popovb/zxRebornClock/README.md

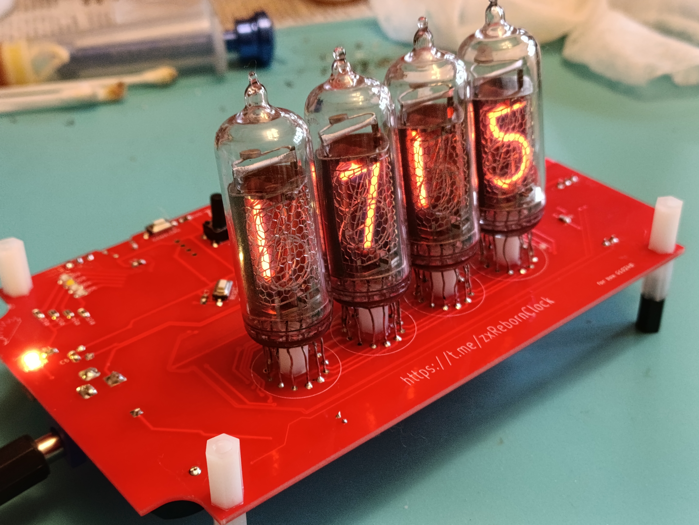
[picture p1: pics/03.jpg]

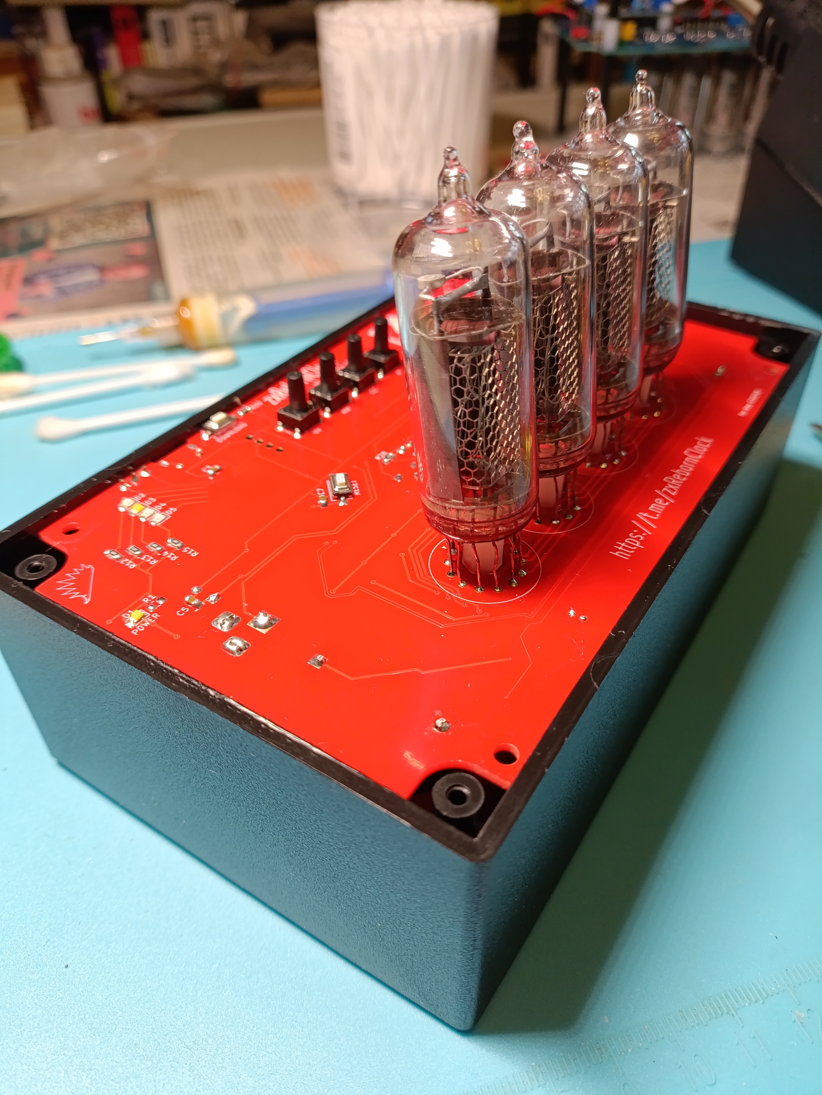
[picture p2: pics/04.jpg]


# ИНСТРУКЦИЯ ПО СБОРКЕ И ЗАПУСКУ

## Повышайка на 200 В

Запаиваем следующие элементы: `J1, U3, C8, R55, C9, L1, D8, C11, D7, Q12, R56, Q11, C10, R57, R58`.
Подключаем 12 В. На С11 долно быть около 200 В. Если есть, переходим к следующему шагу.

## Понижайка на 3.3 В

Запаиваем следующие элементы: `D6, C2, U2, C4, C5, R1, D1`. Подключаем 12 В. На C4 должно быть
3.3 В и горит D1. Если есть, переходим к следующему шагу.

## Микроконтроллер

Запаиваем: `U1, C1, J2, U4, R12-R15, D2-D5, Sw2-Sw6, R29-R33, R53, R54, J4`.

Идём сюда https://github.com/ch32-rs/wchisp/releases/tag/v0.3.0 и берём прошиватор
под нужную платформу. Как минимум работает в Debian и Windows 10.

Плата обесточена. Зажимаем кнопку Download, подрубаем usb кабель к компу, отпускаем кнопку и
у нас несколько секунд, чтобы запустить прошиватор.

Для начала можно дать команду вывода информации чипа: `wchisp info`.

Если заработало, то можно прошить `blink.hex` из раздела релизов. Команда `wchisp flash blink.hex`. Будут
мигать светодиоды D2-D5.

Если всё работает -- прошиваем боевую прошивку: `zxRebornClock.hex`.

## Конфигурирование

Питание 12 В и USB выключены. Зажимаем кнопку F и подаём питание 12 В. Загорается зелёный
светодиод -- контроллер перешёл в режим конфигурирования.

Подключаем к J4 USB-Uart переходник и подключаем его к компьютеру.

Из раздела релизов берём программу конфигуратор `zxrc_configurator.win64.exe` или
`zxrc_configurator_lin64` (проверял в Windows 10 и Debian). Запускаем,
выбираем ком-порт и отвечаем на вопросы. В конце будет выдано подтверждение успеха
конфигурирования.

## Дальше

Запаиваем всё остальное. Должно всё заработать.

## Если не заработало?

Тогда идём сюда и спрашиваем https://t.me/zxRebornClock
