popovb/zxRebornClock/kicad/doc/in-14.pdf

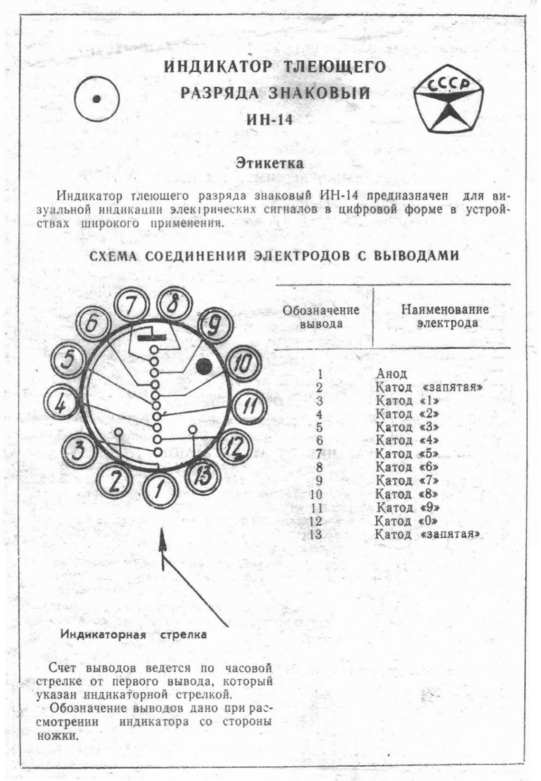
[picture p3: page 1]
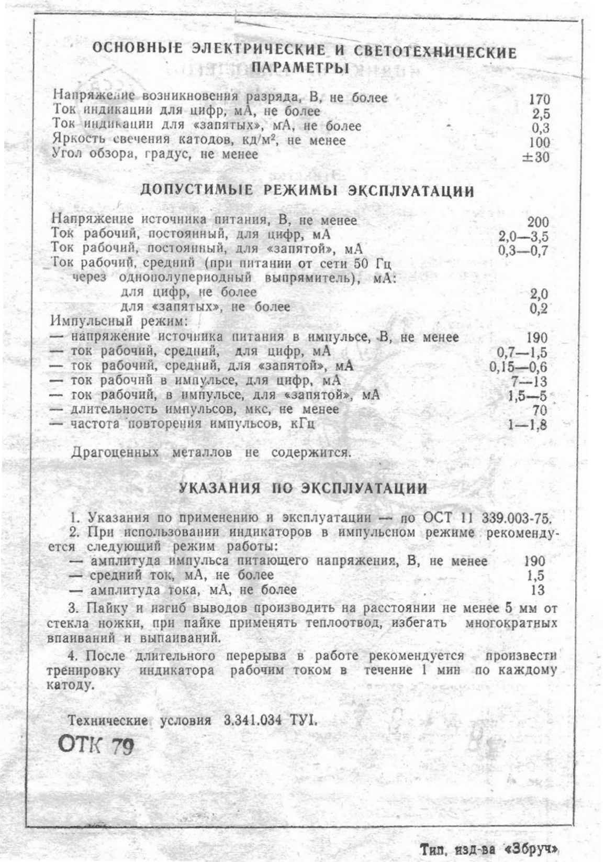
[picture p4: page 2]
