popovb/zxRebornClock/kicad/doc/button.png

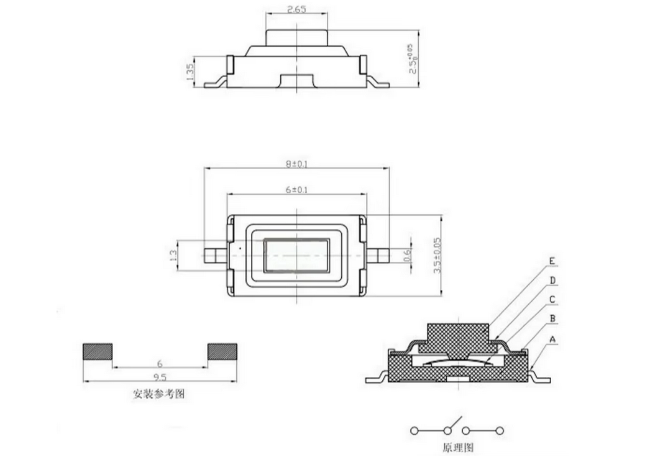
kicad/doc/button.png
