popovb/zxRebornClock/kicad/out/zxRebornClock_back.png

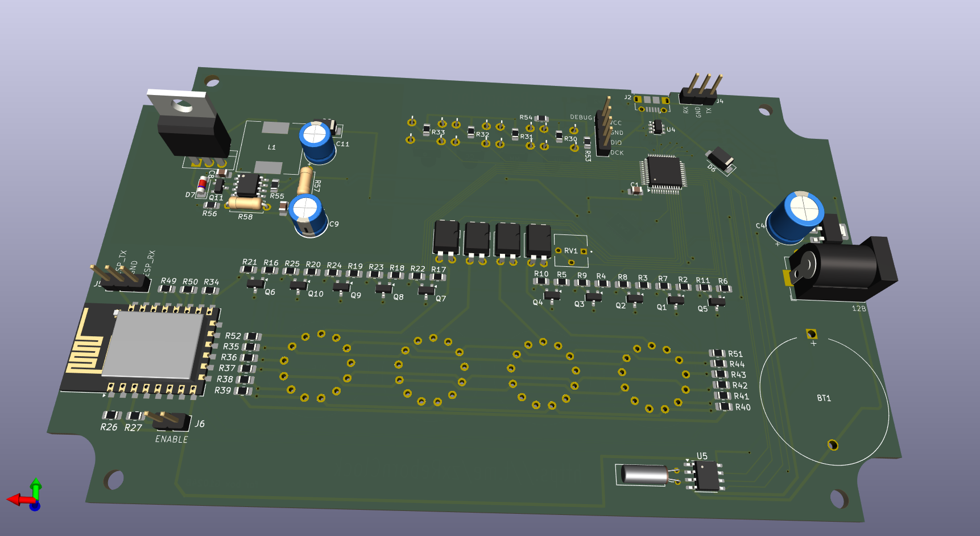
kicad/out/zxRebornClock_back.png
