popovb/zxRebornClock/kicad/out/zxRebornClock_front.png

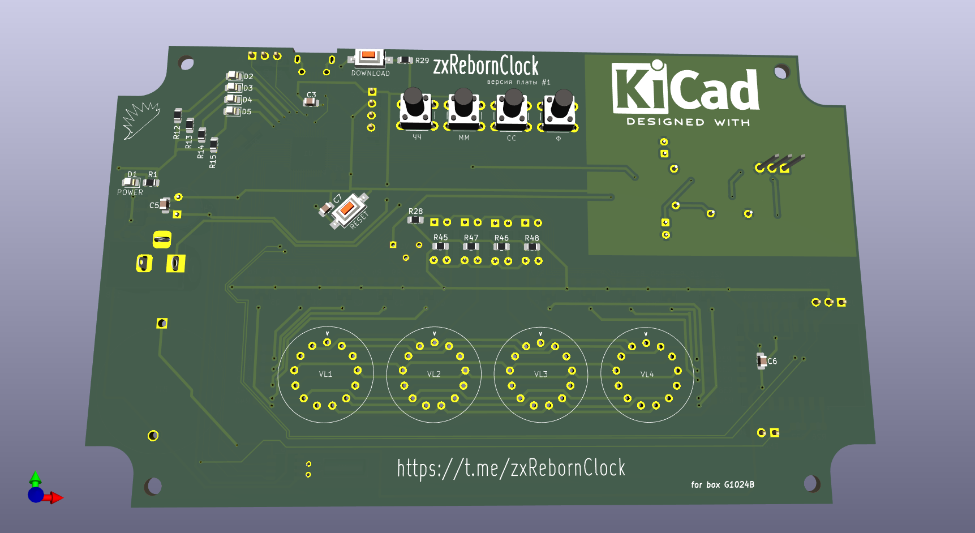
kicad/out/zxRebornClock_front.png
