popovb/zxRebornClock/kicad/out/zxRebornClock.pdf

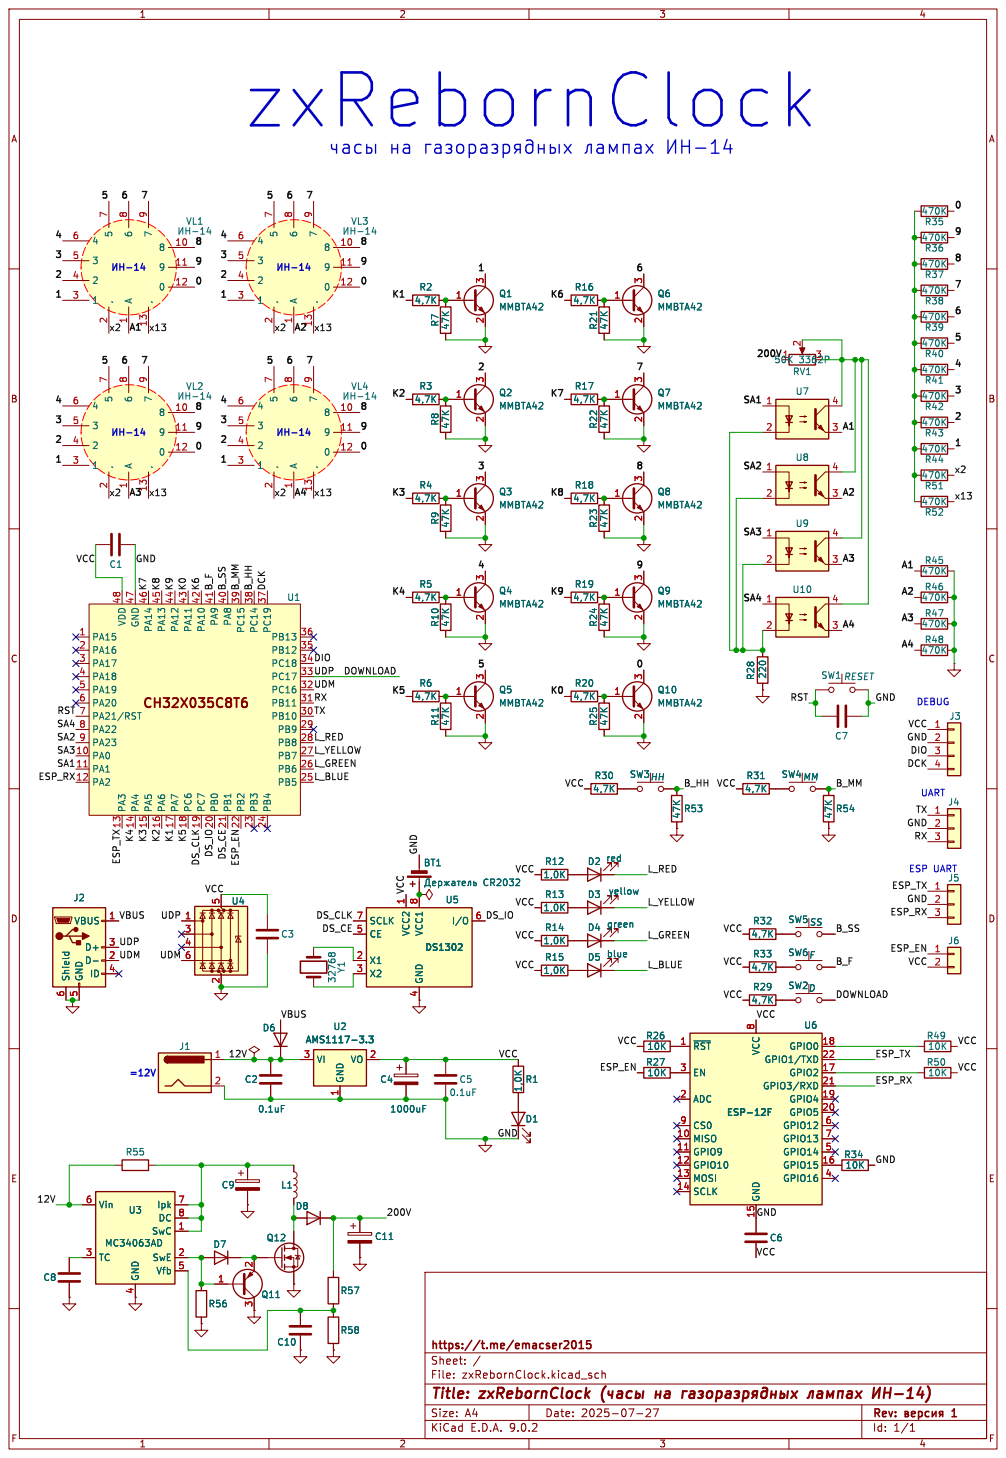
[picture p8: page 1]

Id: 1/1 Title: zxRebornClock þÿ(G0AK þÿ=0þÿ307>@07@O4=KE þÿ;0<?0Eþÿ-14) File: zxRebornClock.kicad_sch Sheet: / https://t.me/emacser2015 D1 R15

8 GND 15 GPIO0 18 GPIO1/TXD 22 GPIO2 17 GPIO3/RXD 21 GPIO4 19 GPIO5 20 GPIO12 6 GPIO13 7 GPIO14 5 GPIO15 16 GPIO16 4 U6 ESP-12F R49

Ipk 7 DC 8 SwC 1 SwE 2 Vfb 5 U3 MC34063AD
