popovb/zxRebornClock/kicad/zxRebornClock/zxRebornClock.kicad_pcb

## KiCad design kicad/zxRebornClock/zxRebornClock.kicad_pcb (2025-08-07)

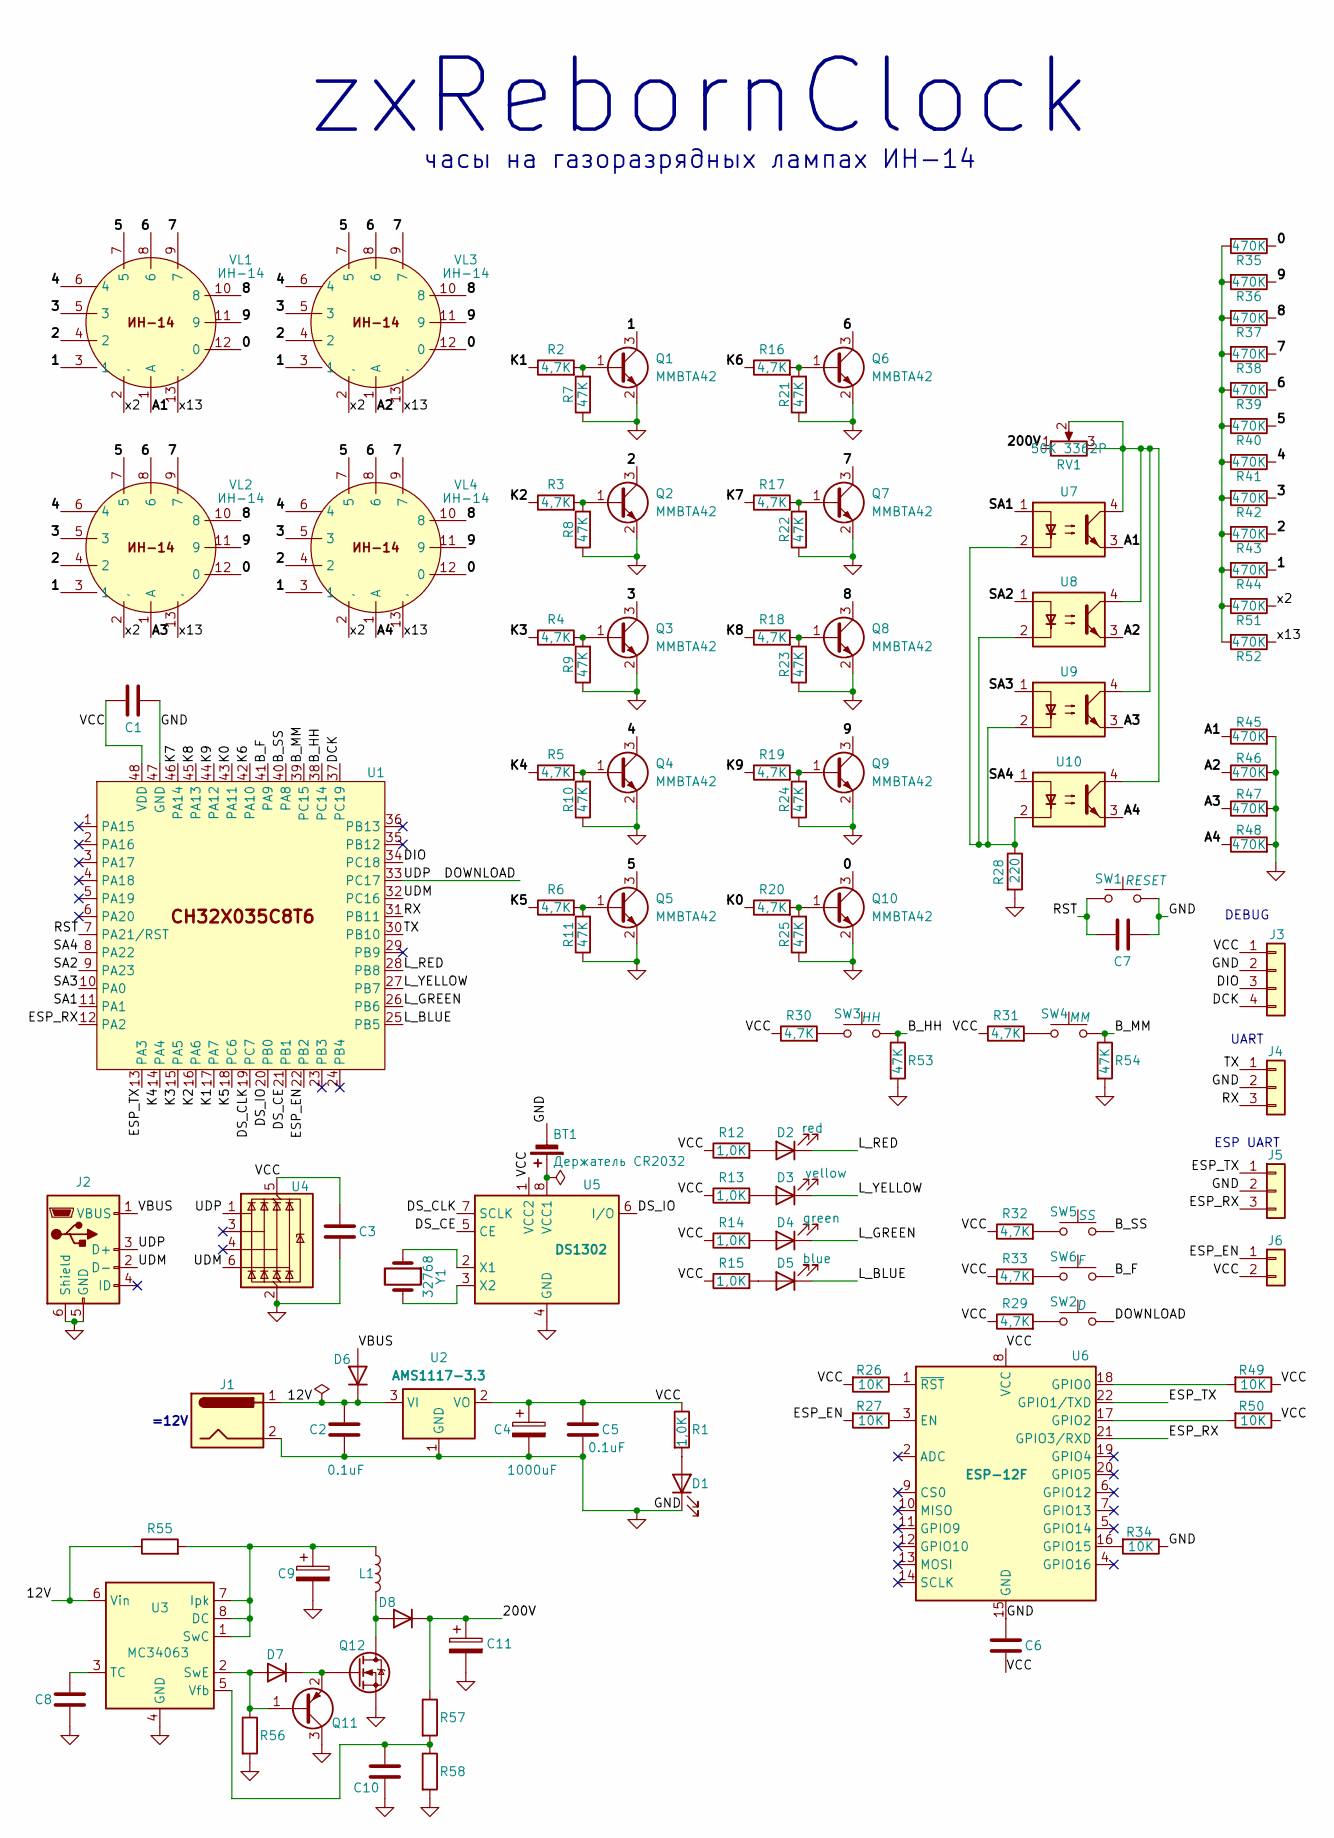
[picture p9: schematic zxRebornClock.kicad_sch, zxRebornClock (часы на газоразрядных лампах ИН-14)]

Parts:
BT1: Держатель CR2032; BatteryHolder_MYOUNG_BS-07-A1BJ001_CR2032
C1, C3, C6, C7: 0,1uF; C_0805_2012Metric_Pad1.18x1.45mm_HandSolder
C2, C5: 0.1uF; C_0805_2012Metric_Pad1.18x1.45mm_HandSolder
C4: 1000uF; CP_Radial_D8.0mm_P3.50mm
C8: 2200pF; C_0805_2012Metric_Pad1.18x1.45mm_HandSolder
C9: 220uF; CP_Radial_D6.3mm_P2.50mm
C10: 0.01uF; C_0805_2012Metric_Pad1.18x1.45mm_HandSolder
C11: 2.2uF; CP_Radial_D6.3mm_P2.50mm
D1: white; LED_0805_2012Metric_Pad1.15x1.40mm_HandSolder
D2: red; LED_0805_2012Metric_Pad1.15x1.40mm_HandSolder
D3: yellow; LED_0805_2012Metric_Pad1.15x1.40mm_HandSolder
D4: green; LED_0805_2012Metric_Pad1.15x1.40mm_HandSolder
D5: blue; LED_0805_2012Metric_Pad1.15x1.40mm_HandSolder
D6, D8: US1G; D_SMA
D7: LL4148; D_MiniMELF
J1: Jack DC; BarrelJack_Horizontal
J2: MicroUSB type B розетка; USB_Micro-B_Molex-105017-0001
J3: Гребёнка 1x4x2.54; PinHeader_1x04_P2.54mm_Vertical
J4, J5: Гребёнка 1x3x2.54; PinHeader_1x03_P2.54mm_Vertical
J6: Гребёнка 1x2x2.54; PinHeader_1x02_P2.54mm_Vertical
L1: 220uH; L_12x12mm_H8mm
Q1, Q2, Q3, Q4, Q5, Q6, Q7, Q8, Q9, Q10: MMBTA42; SOT-23
Q11: MMBTA56; SOT-23
Q12: IRF740; TO-220-3_Vertical
R1, R12, R13, R14, R15: 1,0K; R_0805_2012Metric_Pad1.20x1.40mm_HandSolder
R2, R3, R4, R5, R6, R16, R17, R18, R19, R20, R29, R30, R31, R32, R33: 4,7K; R_0805_2012Metric_Pad1.20x1.40mm_HandSolder
R7, R8, R9, R10, R11, R21, R22, R23, R24, R25, R53, R54: 47K; R_0805_2012Metric_Pad1.20x1.40mm_HandSolder
R26, R27, R34, R49, R50: 10K; R_0805_2012Metric_Pad1.20x1.40mm_HandSolder
R28: 220; R_0805_2012Metric_Pad1.20x1.40mm_HandSolder
R35, R36, R37, R38, R39, R40, R41, R42, R43, R44, R45, R46, R47, R48, R51, R52: 470K; R_0805_2012Metric_Pad1.20x1.40mm_HandSolder
R55: 0.33; R_0805_2012Metric_Pad1.20x1.40mm_HandSolder
R56: 1K; R_0805_2012Metric_Pad1.20x1.40mm_HandSolder
R57: 470K 1%; R_Axial_DIN0207_L6.3mm_D2.5mm_P7.62mm_Horizontal
R58: 3K 1%; R_Axial_DIN0207_L6.3mm_D2.5mm_P7.62mm_Horizontal
RV1: 50K 3362P; TRIM_3362P-1-103
SW1: RESET; SW_SPST_CK_RS282G05A3
SW2: D; SW_SPST_CK_RS282G05A3
SW3: HH; SW_PUSH_6mm_H9.5mm
SW4: MM; SW_PUSH_6mm_H9.5mm
SW5: SS; SW_PUSH_6mm_H9.5mm
SW6: F; SW_PUSH_6mm_H9.5mm
U1: CH32X035C8T6; LQFP-48_7x7mm_P0.5mm
U2: AMS1117-3.3; SOT-223-3_TabPin2
U3: MC34063; SOIC-8_3.9x4.9mm_P1.27mm
U4: USBLC6-4SC6; SOT-23-6
U5: DS1302; SO-8_3.9x4.9mm_P1.27mm
U6: ESP-12F; ESP-12E
U7, U8, U9, U10: TLP627; DIP-4_W7.62mm
VL1, VL2, VL3, VL4: ИН-14
Y1: 32768; Crystal_C38-LF_D3.0mm_L8.0mm_Horizontal

Connections:
/0: Q10.3 (C), R35.1, VL1.12 (0), VL2.12 (0), VL3.12 (0), VL4.12 (0)
/1: Q1.3 (C), R44.1, VL1.3 (1), VL2.3 (1), VL3.3 (1), VL4.3 (1)
/2: Q2.3 (C), R43.1, VL1.4 (2), VL2.4 (2), VL3.4 (2), VL4.4 (2)
/3: Q3.3 (C), R42.1, VL1.5 (3), VL2.5 (3), VL3.5 (3), VL4.5 (3)
/4: Q4.3 (C), R41.1, VL1.6 (4), VL2.6 (4), VL3.6 (4), VL4.6 (4)
/5: Q5.3 (C), R40.1, VL1.7 (5), VL2.7 (5), VL3.7 (5), VL4.7 (5)
/6: Q6.3 (C), R39.1, VL1.8 (6), VL2.8 (6), VL3.8 (6), VL4.8 (6)
/7: Q7.3 (C), R38.1, VL1.9 (7), VL2.9 (7), VL3.9 (7), VL4.9 (7)
/8: Q8.3 (C), R37.1, VL1.10 (8), VL2.10 (8), VL3.10 (8), VL4.10 (8)
/9: Q9.3 (C), R36.1, VL1.11 (9), VL2.11 (9), VL3.11 (9), VL4.11 (9)
/12V: C2.1, D6.1 (K), J1.1, R55.1, U2.3 (VI), U3.6 (Vin)
/200V: C11.1, D8.1 (K), R57.1, RV1.1
/A1: R45.1, U7.3, VL1.1 (A)
/A2: R46.1, U8.3, VL3.1 (A)
/A3: R47.1, U9.3, VL2.1 (A)
/A4: R48.1, U10.3, VL4.1 (A)
/B_F: SW6.2, U1.41 (PA9)
/B_HH: R53.1, SW3.2, U1.38 (PC14)
/B_MM: R54.1, SW4.2, U1.39 (PC15)
/B_SS: SW5.2, U1.40 (PA8)
/DCK: J3.4, U1.37 (PC19)
/DIO: J3.3, U1.34 (PC18)
/DOWNLOAD: J2.3 (D+), SW2.2, U1.33 (PC17), U4.1 (I/O1)
/DS_CE: U1.21 (PB1), U5.5 (CE)
/DS_CLK: U1.19 (PC7), U5.7 (SCLK)
/DS_IO: U1.20 (PB0), U5.6 (I/O)
/ESP_EN: J6.1, R27.2, U1.22 (PB2)
/ESP_RX: J5.3, U1.12 (PA2), U6.21 (GPIO3/RXD)
/ESP_TX: J5.1, U1.13 (PA3), U6.22 (GPIO1/TXD)
/K0: R20.1, U1.43 (PA11)
/K1: R2.1, U1.17 (PA7)
/K2: R3.1, U1.16 (PA6)
/K3: R4.1, U1.15 (PA5)
/K4: R5.1, U1.14 (PA4)
/K5: R6.1, U1.18 (PC6)
/K6: R16.1, U1.42 (PA10)
/K7: R17.1, U1.46 (PA14)
/K8: R18.1, U1.45 (PA13)
/K9: R19.1, U1.44 (PA12)
/L_BLUE: D5.1 (K), U1.25 (PB5)
/L_GREEN: D4.1 (K), U1.26 (PB6)
/L_RED: D2.1 (K), U1.28 (PB8)
/L_YELLOW: D3.1 (K), U1.27 (PB7)
/RST: C7.1, SW1.1, U1.7 (PA21/RST)
/RX: J4.3, U1.31 (PB11)
/SA1: U1.11 (PA1), U7.1
/SA2: U1.9 (PA23), U8.1
/SA3: U1.10 (PA0), U9.1
/SA4: U1.8 (PA22), U10.1
/TX: J4.1, U1.30 (PB10)
/UDM: J2.2 (D-), U1.32 (PC16), U4.6 (I/O4)
/VBUS: D6.2 (A), J2.1 (VBUS)
/VCC: C1.2, C3.1, C4.1, C5.1, C6.2, J3.1, J6.2, R1.1, R12.1, R13.1, R14.1, R15.1, R26.2, R29.1, R30.1, R31.1, R32.1, R33.1, R49.1, R50.1, U1.48 (VDD), U2.2 (VO), U4.5 (VBUS), U5.1 (VCC2), U6.8 (VCC)
/x2: R51.1, VL1.2 (,), VL2.2 (,), VL3.2 (,), VL4.2 (,)
/x13: R52.1, VL1.13 (,), VL2.13 (,), VL3.13 (,), VL4.13 (,)
GND: BT1.2 (-), C1.1, C2.2, C3.2, C4.2, C5.2, C6.1, C7.2, C8.2, C9.2, C10.2, C11.2, D1.1 (K), J1.2, J2.5 (GND), J2.6 (Shield), J3.2, J4.2, J5.2, Q1.2 (E), Q2.2 (E), Q3.2 (E), Q4.2 (E), Q5.2 (E), Q6.2 (E), Q7.2 (E), Q8.2 (E), Q9.2 (E), Q10.2 (E), Q11.3 (C), Q12.3 (S), R7.1, R8.1, R9.1, R10.1, R11.1, R21.1, R22.1, R23.1, R24.1, R25.1, R28.2, R34.1, R45.2, R46.2, R47.2, R48.2, R53.2, R54.2, R56.2, R58.2, SW1.2, U1.47 (GND), U2.1 (GND), U3.4 (GND), U4.2 (GND), U5.4 (GND), U6.15 (GND)
unnamed: BT1.1 (+), U5.8 (VCC1)
unnamed: D1.2 (A), R1.2
unnamed: D2.2 (A), R12.2
unnamed: D3.2 (A), R13.2
unnamed: D4.2 (A), R14.2
unnamed: D5.2 (A), R15.2
unnamed: D7.2 (A), Q11.1 (B), R56.1, U3.2 (SwE)
unnamed: D7.1 (K), Q11.2 (E), Q12.1 (G)
unnamed: D8.2 (A), L1.2, Q12.2 (D)
unnamed: Q1.1 (B), R2.2, R7.2
unnamed: Q2.1 (B), R3.2, R8.2
unnamed: Q3.1 (B), R4.2, R9.2
unnamed: Q4.1 (B), R5.2, R10.2
unnamed: Q5.1 (B), R6.2, R11.2
unnamed: Q6.1 (B), R16.2, R21.2
unnamed: Q7.1 (B), R17.2, R22.2
unnamed: Q8.1 (B), R18.2, R23.2
unnamed: Q9.1 (B), R19.2, R24.2
unnamed: Q10.1 (B), R20.2, R25.2
unnamed: R28.1, U7.2, U8.2, U9.2, U10.2
unnamed: R29.2, SW2.1
unnamed: R30.2, SW3.1
unnamed: R31.2, SW4.1
unnamed: R32.2, SW5.1
unnamed: R33.2, SW6.1
unnamed: R35.2, R36.2, R37.2, R38.2, R39.2, R40.2, R41.2, R42.2, R43.2, R44.2, R51.2, R52.2
unnamed: RV1.2, RV1.3, U7.4, U8.4, U9.4, U10.4
unnamed: C9.1, L1.1, R55.2, U3.1 (SwC), U3.7 (Ipk), U3.8 (DC)
unnamed: C8.1, U3.3 (TC)
unnamed: C10.1, R57.2, R58.1, U3.5 (Vfb)
unnamed: U5.2 (X1), Y1.1
unnamed: U5.3 (X2), Y1.2
unnamed: R27.1, U6.3 (EN)
unnamed: R49.2, U6.18 (GPIO0)
unnamed: R50.2, U6.17 (GPIO2)
unnamed: R34.2, U6.16 (GPIO15)
unnamed: R26.1, U6.1 (~RST)

Notes on the sheet:
=12V
zxRebornClock
DEBUG
часы на газоразрядных лампах ИН-14
UART
ESP UART

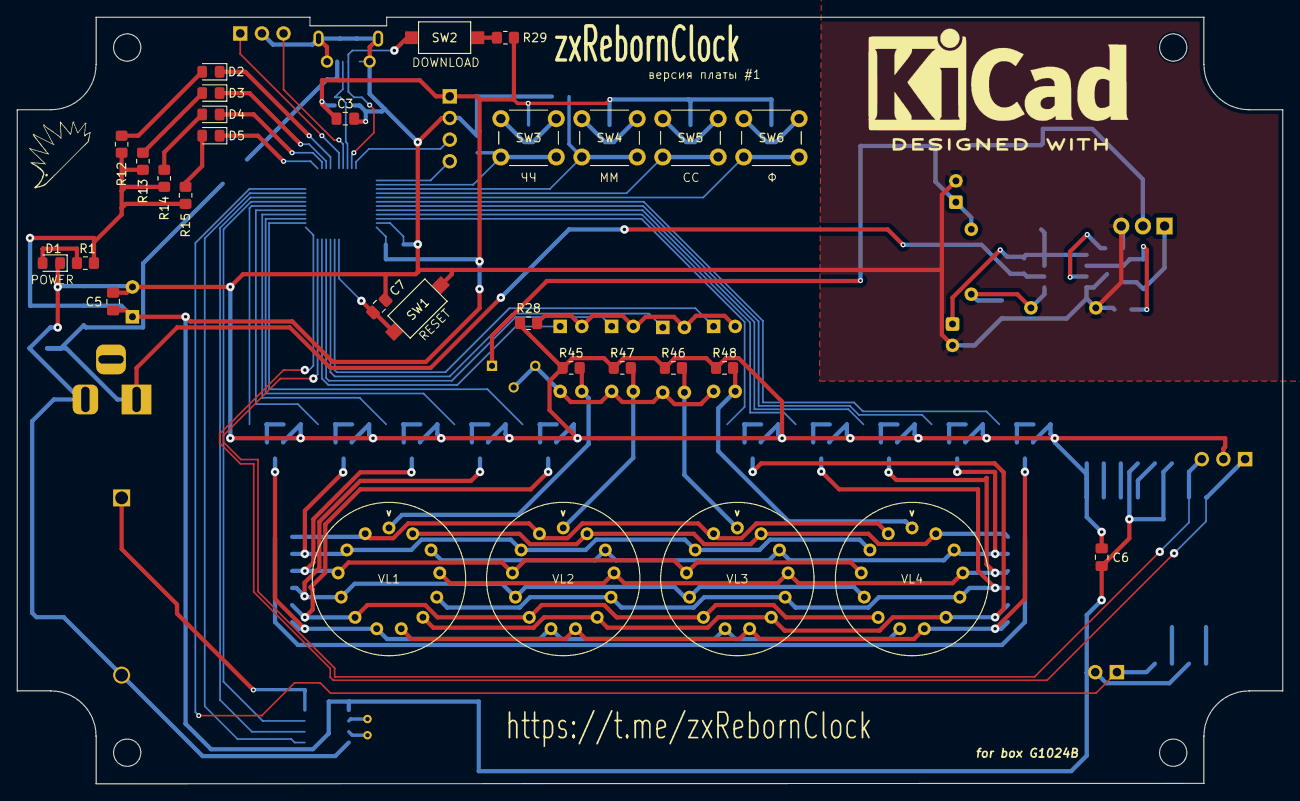
[picture p10: board zxRebornClock.kicad_pcb from above]

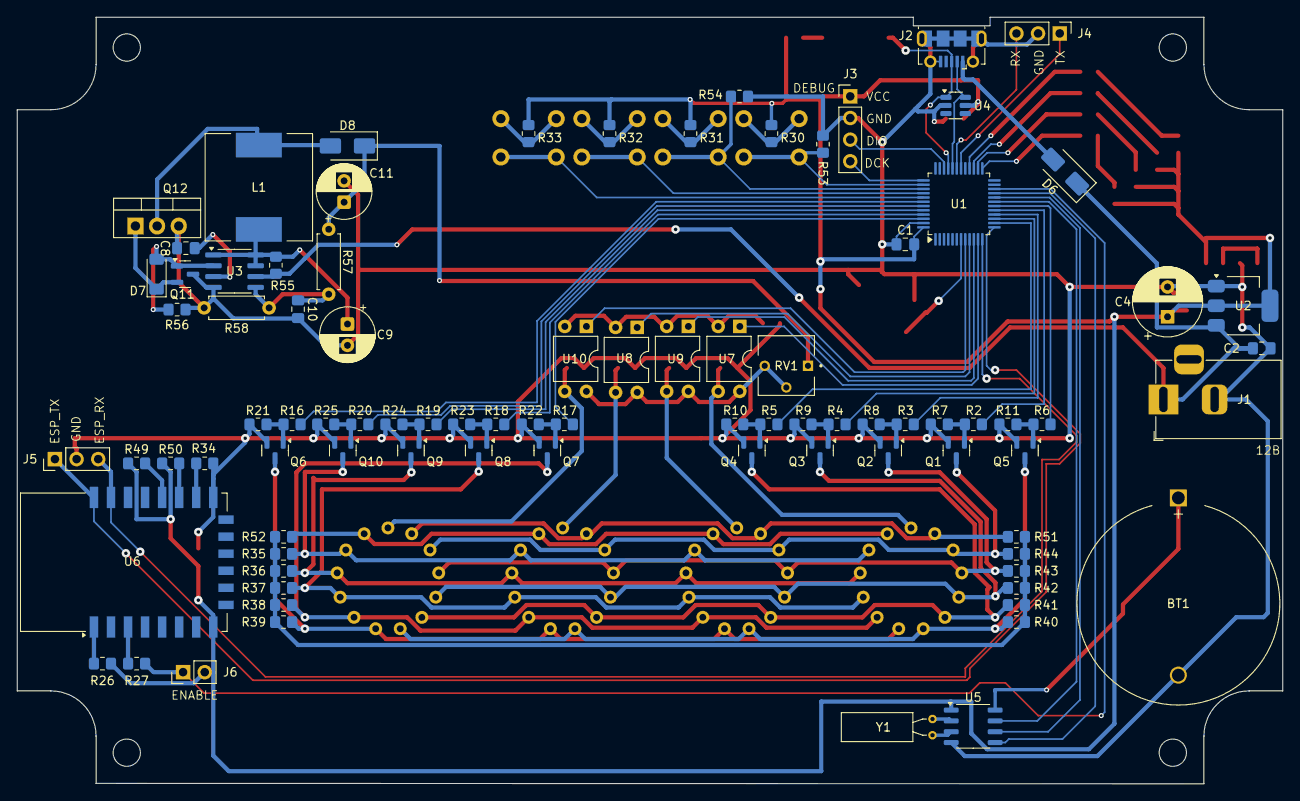
[picture p11: board zxRebornClock.kicad_pcb from below]

Board: 2 copper layers, 148.5 x 90.0 mm, 123 parts (89 on the bottom side), 93 nets.

Other parts of the board:
H24, H25, H26, H27: MountingHole; MountingHole_3.2mm_M3
