popovb/zxRebornClock/firmware/source/src/core/Mcu.cpp

//
// Copyright (c) 2024 Boris Popov <popov@whitekefir.ru>
//

#include "core/Mcu.hpp"
#include "Gpio.hpp"
#include "Usart.hpp"
#include "LedPinConf.hpp"
#include "ButtonPinConf.hpp"
#include "PortHolder.hpp"
#include "PinHolder.hpp"
#include "UsartHolder.hpp"

#ifndef UNITTEST
#include "ch32x035.h"
#include "ch32x035_flash.h"
#include "debug.h"
#endif

gric::Mcu::Mcu() {
     init();
}

void gric::Mcu::init() const {
     nvic_config();
     clock_update();
}

void gric::Mcu::init(const UartConf& uc) {
     if (pct.is_off(uc.name)) pct.on(uc.name);
     init(uc.name, uc.speed);
}

void gric::Mcu::init(const PinTxConf& v) {
     PinConf pc(PinDir::Out, PinMode::Alter);
     init(v, pc);
}

void gric::Mcu::init(const PinRxConf& v) {
     PinConf pc(PinDir::In, PinMode::Float);
     init(v, pc);
}

void gric::Mcu::init(UartName::name_t n, u32 s) const {
     Usart uart;
     uart.init(n, s);
}

void gric::Mcu::init(const PortPinConf& pp, const PinConf& pc) {
     if (pct.is_off(pp.port)) pct.on(pp.port);
     Gpio gpio;
     gpio.init(pp, pc);
}

void gric::Mcu::init(const Pin& p, const PinConf& pc) const {
     Gpio gpio;
     gpio.init(p, pc);
}

void gric::Mcu::init(const LedConf& v) {
     PortPinConf pp(v);
     LedPinConf lpc;
     init(pp, lpc);
     get(v).off();
}

void gric::Mcu::init(const ButtonConf& v, PinMode::mode_t p) {
     PortPinConf pp(v);
     ButtonPinConf lpc(p);
     init(pp, lpc);
}

gric::Led gric::Mcu::get(const LedConf& lc) const {
     PortHolder poh;
     PinHolder pih;
     return Led(poh.get(lc.port), pih.get(lc.pin));
}

gric::Button gric::Mcu::get(const ButtonConf& lc) const {
     PortHolder poh;
     PinHolder pih;
     return Button(poh.get(lc.port), pih.get(lc.pin));
}

gric::Pin gric::Mcu::get(const PortPinConf& pc) const {
     PortHolder poh;
     PinHolder pih;
     return Pin(poh.get(pc.port), pih.get(pc.pin));
}

gric::Uart gric::Mcu::get(UartName::name_t n) const {
     UsartHolder uh;
     return uh.get(n);
}

bool gric::Mcu::flash_erase(u32 a, u32 l) const {
     FLASH_Status s = FLASH_ROM_ERASE(a, l);
     return (s == FLASH_COMPLETE);
}

bool gric::Mcu::flash_write(u32 a, u32* b, u32 l) const {
     FLASH_Status s = FLASH_ROM_WRITE(a, b, l);
     return (s == FLASH_COMPLETE);
}

#ifdef    UNITTEST

void gric::Mcu::init(const PrintConf&) const {
     return;
}

void gric::Mcu::nvic_config() const {
     return;
}

void gric::Mcu::clock_update() const {
     return;
}

#else //  UNITTEST

void gric::Mcu::nvic_config() const {
     NVIC_PriorityGroupConfig(NVIC_PriorityGroup_1);
}

void gric::Mcu::clock_update() const {
     SystemCoreClockUpdate();
}

void gric::Mcu::init(const PrintConf& v) const {
     USART_Printf_Init(v.speed);
     printf("SystemCoreClock: %d\r\n", (int)SystemCoreClock);
     printf("ChipID: %08x\r\n", (int)DBGMCU_GetCHIPID());
}

#endif // UNITTEST
