popovb/zxRebornClock/firmware/source/src/core/Usart.cpp

//
// Copyright (c) 2025 Boris Popov <popov@whitekefir.ru>
//

#include "Usart.hpp"
#include "UsartHolder.hpp"

#ifdef UNITTEST

void gric::Usart::init(UartName::name_t, u32) const {
     return;
}

void gric::Usart::disable(u32) const {
     return;
}

void gric::Usart::enable(u32) const {
     return;
}

void gric::Usart::send(u32, u8) const {
     return;
}

gric::u8 gric::Usart::receive(u32) const {
     return 0;
}

bool gric::Usart::tx_empty(u32) const {
     return true;
}

bool gric::Usart::rx_empty(u32) const {
     return true;
}

bool gric::Usart::rx_not_empty(u32) const {
     return true;
}

bool gric::Usart::tx_not_empty(u32) const {
     return true;
}

#else
#include "ch32x035.h"

void gric::Usart::init(UartName::name_t n, u32 s) const {
     UsartHolder uh;
     USART_InitTypeDef u;
     u.USART_BaudRate = s;
     u.USART_WordLength = USART_WordLength_8b;
     u.USART_StopBits = USART_StopBits_1;
     u.USART_Parity = USART_Parity_No;
     u.USART_HardwareFlowControl = USART_HardwareFlowControl_None;
     u.USART_Mode = USART_Mode_Tx | USART_Mode_Rx;
     USART_Init((USART_TypeDef*)(uh.get(n)), &u);
}

void gric::Usart::disable(u32 v) const {
     USART_Cmd((USART_TypeDef*)v, DISABLE);
}

void gric::Usart::enable(u32 v) const {
     USART_Cmd((USART_TypeDef*)v, ENABLE);
}

void gric::Usart::send(u32 u, u8 v) const {
     u16 vv = v;
     USART_SendData((USART_TypeDef*)u, vv);
}

gric::u8 gric::Usart::receive(u32 u) const {
     u16 vv = USART_ReceiveData((USART_TypeDef*)u);
     return vv & 0x00FF;
}

bool gric::Usart::tx_empty(u32 u) const {
     return (USART_GetFlagStatus((USART_TypeDef*)u,
				 USART_FLAG_TXE) == SET);
}

bool gric::Usart::tx_not_empty(u32 u) const {
     return (USART_GetFlagStatus((USART_TypeDef*)u,
				 USART_FLAG_TXE) == RESET);
}

bool gric::Usart::rx_not_empty(u32 u) const {
     return (USART_GetFlagStatus((USART_TypeDef*)u,
				 USART_FLAG_RXNE) == SET);
}

bool gric::Usart::rx_empty(u32 u) const {
     return (USART_GetFlagStatus((USART_TypeDef*)u,
				 USART_FLAG_RXNE) == RESET);
}
#endif
