popovb/zxRebornClock/firmware/source/src/KeyBlockReactor.hpp

//
// Copyright (c) 2025 Boris Popov <popov@whitekefir.ru>
//

#include "KeyBlockEvent.hpp"
#include "LedBlockControl.hpp"
#include "Rtc.hpp"
#include "InternetTime.hpp"

#ifndef _GRIC_KEY_BLOCK_REACTOR_HPP_
#define _GRIC_KEY_BLOCK_REACTOR_HPP_

namespace gric {

     class KeyBlockReactor {

     public:
	  KeyBlockReactor(LedBlockControl&,
			  const Rtc&,
			  InternetTime&);

	  void handle(const KeyBlockEvent&, u8[4]) const;

     private:
	  LedBlockControl& lbc;
	  const Rtc& rtc;
	  InternetTime& it;

     private:
	  void hour(KeyEvent::event_t, u8, u8) const;
	  void minute(KeyEvent::event_t, u8, u8) const;
	  void second(KeyEvent::event_t) const;
	  void func(KeyEvent::event_t) const;
     };
}
#endif // _GRIC_KEY_BLOCK_REACTOR_HPP_
