popovb/zxRebornClock/firmware/source/src/Time.hpp

//
// Copyright (c) 2024 Boris Popov <popov@whitekefir.ru>
//

#include "core/Types.hpp"

#ifndef _GRIC_TIME_HPP_
#define _GRIC_TIME_HPP_

namespace gric {

     ///////////////////////////////////////////////////////////
     class Time {

	  friend class TimeChecker;
	  friend bool operator==(const Time&, const Time&);

     public:
	  Time();
	  Time(u8, u8);
	  Time(u8, u8, u8);

	  void fill(u8[4]) const;
	  operator bool() const;

	  i8 get_hour() const;
	  i8 get_minute() const;
	  i8 get_second() const;

     private:
	  i8 hour;
	  i8 minute;
	  i8 second;
     };
     ///////////////////////////////////////////////////////////

     ///////////////////////////////////////////////////////////
     bool operator==(const Time&, const Time&);
     ///////////////////////////////////////////////////////////
}
#endif // _GRIC_TIME_HPP_
