popovb/zxRebornClock/firmware/source/src/RedLed.hpp

//
// Copyright (c) 2025 Boris Popov <popov@whitekefir.ru>
//

#include "SimpleLed.hpp"
#include "McuNetConfig.hpp"
#include "core/Mcu.hpp"

#ifndef _GRIC_RED_LED_HPP_
#define _GRIC_RED_LED_HPP_

namespace gric {

     class RedLed : public SimpleLed {

     public:
	  RedLed(const Mcu&,
		 const McuNetConfig&);

     // 	  void on();
     // 	  void off();

     // private:
     // 	  void init(const Mcu&, const McuNetConfig&);

     // private:
     // 	  Led led;
     };
}
#endif // _GRIC_RED_LED_HPP_
