popovb/zxRebornClock/firmware/source/src/Minute.hpp

//
// Copyright (c) 2025 Boris Popov <popov@whitekefir.ru>
//

#include "core/Types.hpp"

#ifndef _GRIC_MINUTE_HPP_
#define _GRIC_MINUTE_HPP_

namespace gric {

     class Minute {

     public:
	  Minute(u8, u8);

	  void operator++();

	  u8 get() const;

     private:
	  u8 value;
     };
}
#endif // _GRIC_MINUTE_HPP_
