popovb/zxRebornClock/firmware/source/src/LedColor.hpp

//
// Copyright (c) 2025 Boris Popov <popov@whitekefir.ru>
//

#ifndef _GRIC_LED_COLOR_HPP_
#define _GRIC_LED_COLOR_HPP_

namespace gric {

     class LedColor {

     public:
	  enum color_t {
	       Red    = 0,
	       Yellow = 1,
	       Green  = 2,
	       Blue   = 3,
	  };
     };
}
#endif // _GRIC_LED_COLOR_HPP_
