popovb/zxRebornClock/firmware/source/src/core/RccPortHolder.cpp

//
// Copyright (c) 2024 Boris Popov <popov@whitekefir.ru>
//

#include "RccPortHolder.hpp"
#include "ch32x035.h"

///////////////////////////////////////////////////////////////////
const gric::u32
gric::RccPortHolder::rcc[] = {
     RCC_APB2Periph_GPIOA,
     RCC_APB2Periph_GPIOB,
     RCC_APB2Periph_GPIOC,
};
///////////////////////////////////////////////////////////////////

///////////////////////////////////////////////////////////////////
gric::u32 gric::RccPortHolder::get(PortName::name_t v) const {
     return rcc[v];
}
///////////////////////////////////////////////////////////////////
