popovb/zxRebornClock/firmware/source/src/core/UsartHolder.cpp

//
// Copyright (c) 2024 Boris Popov <popov@whitekefir.ru>
//

#include "UsartHolder.hpp"
#include "ch32x035.h"

///////////////////////////////////////////////////////////////////
const gric::u32
gric::UsartHolder::usarts[] = {
     USART1_BASE,
     USART2_BASE,
     USART3_BASE,
     USART4_BASE,
};
///////////////////////////////////////////////////////////////////

///////////////////////////////////////////////////////////////////
gric::u32 gric::UsartHolder::get(UartName::name_t v) const {
     return usarts[v];
}
///////////////////////////////////////////////////////////////////
