popovb/zxRebornClock/firmware/source/src/core/RccApb2Holder.cpp

//
// Copyright (c) 2024 Boris Popov <popov@whitekefir.ru>
//

#include "RccApb2Holder.hpp"

#ifndef UNITTEST
#include "ch32x035.h"

///////////////////////////////////////////////////////////////////
const gric::u32
gric::RccApb2Holder::rcc_apb2[] = {
     RCC_APB2Periph_GPIOA,
     RCC_APB2Periph_GPIOB,
     RCC_APB2Periph_GPIOC,
};
///////////////////////////////////////////////////////////////////

///////////////////////////////////////////////////////////////////
gric::u32 gric::RccApb2Holder::get(PortName::name_t v) const {
     return rcc_apb2[v];
}
///////////////////////////////////////////////////////////////////
#endif
