popovb/zxRebornClock/firmware/source/src/core/PortHolder.cpp

//
// Copyright (c) 2024 Boris Popov <popov@whitekefir.ru>
//

#include "PortHolder.hpp"
#include "ch32x035.h"

///////////////////////////////////////////////////////////////////
const gric::u32
gric::PortHolder::ports[] = {
     GPIOA_BASE,
     GPIOB_BASE,
     GPIOC_BASE,
};
///////////////////////////////////////////////////////////////////

///////////////////////////////////////////////////////////////////
gric::u32 gric::PortHolder::get(PortName::name_t v) const {
     return ports[v];
}
///////////////////////////////////////////////////////////////////
