popovb/zxRebornClock/firmware/source/src/interrupt.c

#include "ch32x035_it.h"

///////////////////////////////////////////////////////////////////
void NMI_Handler()
     __attribute__((interrupt("WCH-Interrupt-fast")));

void HardFault_Handler()
     __attribute__((interrupt("WCH-Interrupt-fast")));
///////////////////////////////////////////////////////////////////

///////////////////////////////////////////////////////////////////
void NMI_Handler() {
     while (1) {
     }
}

void HardFault_Handler() {
     while (1) {
     }
}
///////////////////////////////////////////////////////////////////
