popovb/zxRebornClock/(commit log)

2024-11-12 fix case for link.ld
2024-12-14 Реорганизация кода
2024-12-15 add impl for ctor for PrintConf
2024-12-15 add proto for LedConf
2024-12-15 add impl for ctor for LedConf
2024-12-15 add proto for LedPinConf
2024-12-15 add impl for ctor for LedPinConf
2024-12-16 add impl for Led::toggle
2024-12-16 add impl for Led::on
2024-12-16 add impl for Led::off
2024-12-16 add impl for ctor for Led
2024-12-21 add proto for Pin
2024-12-21 add impl for ctor for Pin
2024-12-21 fix proto for Pin
    [main.cpp]
2024-12-21 add impl for Pin::write
2024-12-21 add impl for Pin::read
2024-12-25 fix proto for McuNetConfig
    [McuNetConfig.cpp, McuNetConfig.hpp]
2024-12-26 fix proto for Anodes
    [Anodes.hpp]
2024-12-26 fix proto for Cathodes
    [Cathodes.hpp]
2024-12-26 fix proto for Tubes
    [Tubes.hpp]
2024-12-26 fix proto for Anodes, Cathodes
    [Anodes.hpp, Cathodes.hpp]
2024-12-26 fix impl for Tubes
    [Tubes.cpp]
2024-12-26 fix impl for Cathodes
    [Cathodes.cpp, Cathodes.hpp]
2024-12-26 fix proto for Counter
    [Counter.hpp, main.cpp]
2024-12-26 fix proto for DigitExtractor
    [DigitExtractor.hpp]
2024-12-26 add led conf
2024-12-28 fix proto for Rtc
    [Rtc.cpp, Rtc.hpp]
2024-12-28 fix proto for RtcPin
    [RtcPin.hpp]
2025-01-04 fix proto for DelayerNop
    [Tubes.hpp]
2025-01-18 fix Tubes
2025-01-20 add proto for UartName
2025-01-20 add proto for UartConf
2025-01-20 add impl for UartConf
2025-01-20 add impl for Mcu::init(const UartConf&)
2025-01-20 add proto for Uart
2025-01-20 add impl for Uart::init
2025-01-20 fix impl for Uart
    [Uart.cpp]
2025-01-20 fix proto for PortClockToggler
    [PortClockToggler.cpp]
2025-01-21 add impl for Mcu::get(UartName::name_t
2025-01-21 begin impl for Uart
2025-01-21 fix proto for Uart
    [Uart.hpp, main.cpp]
2025-01-22 add impl for Uart::disable
2025-01-22 add impl for Uart::enable
2025-01-22 add impl for Uart::send
2025-01-22 add impl for Uart::receive
2025-01-22 add impl for Uart::tx_empty
2025-01-22 add impl for Uart::rx_not_empty
2025-01-24 begin kicad project
    [zxRebornClock.kicad_pcb, zxRebornClock.kicad_sch]
2025-02-06 change transistors
    [zxRebornClock.kicad_sch]
2025-02-06 add VLs
    [zxRebornClock.kicad_sch]
2025-02-06 add mcu
    [zxRebornClock.kicad_sch]
2025-02-06 add R nominals
    [zxRebornClock.kicad_sch]
2025-02-11 Обновлено УГО для MCU
    [zxRebornClock.kicad_sch]
2025-02-11 add DEBUG connector
    [zxRebornClock.kicad_sch]
2025-02-11 add UART connector
    [zxRebornClock.kicad_sch]
2025-02-11 add ds1302
    [zxRebornClock.kicad_sch]
2025-02-11 add esp12f
    [zxRebornClock.kicad_sch]
2025-02-11 add control buttons
    [zxRebornClock.kicad_sch]
2025-02-11 add leds
    [zxRebornClock.kicad_sch]
2025-02-11 add usb
    [zxRebornClock.kicad_sch]
2025-02-11 add Download button
    [zxRebornClock.kicad_sch]
2025-02-12 add power 3.3V
    [zxRebornClock.kicad_sch]
2025-02-12 add some fixes
    [zxRebornClock.kicad_sch]
2025-02-20 fix GPIO0 on esp12f
    [zxRebornClock.kicad_sch]
2025-02-20 add esp uart connector
    [zxRebornClock.kicad_sch]
2025-02-20 add power for mcu
    [zxRebornClock.kicad_sch]
2025-02-20 add rst button
    [zxRebornClock.kicad_sch]
2025-02-20 add 12V->200V
    [zxRebornClock.kicad_sch]
2025-02-20 fix border
    [zxRebornClock.kicad_sch]
2025-02-21 add some ground symbol fixes
    [zxRebornClock.kicad_sch]
2025-02-21 begin footprint setting
    [zxRebornClock.kicad_sch]
2025-02-21 footprint setting in progress
    [zxRebornClock.kicad_sch]
2025-02-23 add quarz footprint
    [zxRebornClock.kicad_sch]
2025-02-23 add battery holder footprint
    [zxRebornClock.kicad_sch]
2025-02-23 add button pic
2025-02-24 add usb footprint
    [zxRebornClock.kicad_sch]
2025-02-24 add button footprint
    [zxRebornClock.kicad_sch]
2025-02-24 add potentiometer footprint
    [zxRebornClock.kicad_sch]
2025-02-24 fix 12v=>200v
    [zxRebornClock.kicad_sch]
2025-02-24 some fixes
    [zxRebornClock.kicad_sch]
2025-02-24 add 12v=>200v footprint
    [zxRebornClock.kicad_sch]
2025-02-24 add footprint for pads
    [zxRebornClock.kicad_sch]
2025-02-25 add fotprint for in14
    [zxRebornClock.kicad_sch]
2025-02-25 begin board
    [zxRebornClock.kicad_pcb]
2025-02-25 add edge
    [zxRebornClock.kicad_pcb]
2025-02-25 work in progress
    [zxRebornClock.kicad_pcb]
2025-02-25 fix footprint for 12v_200v
    [zxRebornClock.kicad_pcb]
2025-02-26 fix cathode connect
    [zxRebornClock.kicad_sch]
2025-02-27 fix reset
    [zxRebornClock.kicad_pcb]
2025-02-28 fix schema
    [zxRebornClock.kicad_sch]
2025-02-28 fix ESD
    [zxRebornClock.kicad_pcb]
2025-02-28 fix debug connector
    [zxRebornClock.kicad_pcb]
2025-02-28 fix leds
    [zxRebornClock.kicad_pcb]
2025-02-28 first board iteration is completed
    [zxRebornClock.kicad_pcb]
2025-02-28 fix front silk
    [zxRebornClock.kicad_pcb]
2025-02-28 fix back silk
    [zxRebornClock.kicad_pcb]
2025-02-28 add logos
    [zxRebornClock.kicad_pcb]
2025-02-28 add logo
    [zxRebornClock.kicad_pcb]
2025-02-28 add gerbers
2025-04-03 ibom: work in progress
    [zxRebornClock.kicad_sch]
2025-04-03 fix pcb
    [zxRebornClock.kicad_pcb]
2025-04-06 fix kicad/.gitignore
2025-04-21 ibom is completed
    [zxRebornClock.kicad_pcb, zxRebornClock.kicad_sch]
2025-04-22 add LedColor
2025-04-22 fix McuNetConfig for LedBlock
    [McuNet.hpp, McuNetConfig.cpp, McuNetConfig.hpp]
2025-04-22 add impl for ctor for LedBlock
2025-04-22 add impl for LedBlock::init
2025-04-22 add LedTaskMode
2025-04-22 begin proto for LedTaskTime
2025-04-22 add impl for ctor for LedTaskTime
2025-04-22 fix LedTaskMode
2025-04-22 begin proto for LedTask
2025-04-22 add impl for ctor for LedTask
2025-04-22 add proto for LedBlockControl
2025-04-23 add impl for Tubes::calc_iters_per_second
2025-04-23 fix proto for DisplayTime
    [DisplayTime.hpp, test.cpp]
2025-04-23 fix impl for ctor for DisplayTime
    [DisplayTime.cpp, DisplayTime.hpp]
2025-04-23 add impl for ctor for LedBlockControl
2025-04-23 fix proto for LedBlockControl
    [LedBlockControl.cpp, LedBlockControl.hpp, LedTask.hpp]
2025-04-23 add impl for LedBlockControl::poll
2025-04-23 add impl for LedTask::operator bool
2025-04-23 fix proto for LedTask
    [LedTask.cpp, LedTask.hpp, test.cpp]
2025-04-23 add impl for LedBlockControl::poll_start
2025-04-23 add impl for LedBlockControl::poll_continue
2025-04-23 add impl for Led::operator bool
2025-04-24 add impl for LedBlockControl::poll_continue_up
2025-04-24 add impl for LedBlockControl::poll_continue_down
2025-04-24 add impl for LedBlockControl::set
2025-05-08 fix ockControl:: poll_continue_up, poll_continue_down
    [LedBlockControl.cpp]
2025-05-09 add impl for Tubes::get_times
2025-05-29 begin conf for buttons ports
2025-05-29 add impl for Mcu::init(const ButtonConf&)
2025-05-29 add impl for ctor for ButtonPinConf
2025-05-29 add impl for ctor for ButtonConf
2025-05-29 add impl for Mcu::get(const ButtonConf&)
2025-05-29 add impl for Button
2025-05-31 fix proto for Key
    [Key.cpp, Key.hpp]
2025-05-31 add impl for ctor for Button
2025-06-15 fix Usart:: send, receive
    [Usart.cpp]
2025-06-21 add impl for Uart::tx_not_empty
2025-06-21 fix proto for EspReceiveBuffer
    [Esp12f.cpp, EspReceiveBuffer.cpp, EspReceiveBuffer.hpp, main.cpp]
2025-06-21 fix proto for InternetTime
    [InternetTime.cpp, InternetTime.hpp, SecondsCounter.hpp]
2025-06-21 add impl for SecondsCounter::reset
    [SecondsCounter.cpp, SecondsCounter.hpp]
2025-06-22 fix proto for KeyBlockReactor
    [KeyBlockReactor.cpp, KeyBlockReactor.hpp, main.cpp]
2025-06-29 fix ctor for GreenLed
    [GreenLed.cpp]
2025-06-29 fix proto for set_settings
    [main.cpp]
2025-06-29 add proto for UartExchanger
2025-07-12 add impl for ctor for UartExchanger
2025-07-12 add impl for UartExchanger::init_uart
2025-07-12 fix proto for UartExchanger
    [UartExchanger.hpp, main.cpp]
2025-07-12 add impl for UartExchanger::enable
2025-07-12 add impl for UartExchanger::disable
2025-07-12 add impl for UartExchanger::write
2025-07-12 add impl for UartExchanger::wait_sending
2025-07-12 fix ClockToggler for Uart1
    [ClockToggler.cpp, Usart.cpp]
2025-07-12 add impl for UartExchanger::write_buffer
2025-07-13 fix UartExchanger
2025-07-13 add impl for UartExchanger::reset
    [UartExchanger.cpp]
2025-07-13 add impl for UartExchanger::get
2025-07-19 fix proto for FlashSettings
    [FlashSettings.hpp, main.cpp]
2025-07-20 add impl for InternetTime::reset_new_time
    [InternetTime.cpp]
2025-07-26 fix find port in win
    [SerialPortFinder.py]
2025-07-27 add pull-down for B_HH, B_MM
    [zxRebornClock.kicad_pcb, zxRebornClock.kicad_sch]
2025-07-27 U5 to SO-5
    [zxRebornClock.kicad_pcb, zxRebornClock.kicad_sch]
2025-07-27 new place for leds
    [zxRebornClock.kicad_pcb]
2025-07-27 add D6
    [zxRebornClock.kicad_pcb, zxRebornClock.kicad_sch]
2025-07-27 add pumper on board
    [zxRebornClock.kicad_pcb, zxRebornClock.kicad_sch]
2025-07-28 add new gerbers
2025-08-07 begin edit ibom
    [zxRebornClock.kicad_pcb, zxRebornClock.kicad_sch]
2025-08-07 fix C for ibom
    [zxRebornClock.kicad_pcb, zxRebornClock.kicad_sch]
2025-08-07 fix R for ibom
    [zxRebornClock.kicad_pcb, zxRebornClock.kicad_sch]
2025-08-07 fix L, D for ibom
    [zxRebornClock.kicad_pcb, zxRebornClock.kicad_sch]
2025-08-07 fix U for ibom
    [zxRebornClock.kicad_pcb, zxRebornClock.kicad_sch]
2025-08-07 fix Q for ibom
    [zxRebornClock.kicad_pcb, zxRebornClock.kicad_sch]
